brentonford/AutoHelm/AutoHelm roadmap 202512.md

# AutoHelm Recommendations

## Recommended Future Improvements

### Navigation & Waypoints

#### **4. Waypoint Preview Mode**
- **Problem:** No way to see route without committing to navigation
- **Solution:** Add "Preview Route" option showing distance, bearing, estimated time
- **Benefit:** Allows planning before engaging navigation

#### **5. Quick Waypoint Access**
- **Problem:** Need to open multiple screens to access waypoints
- **Solution:** Add floating button on map for quick waypoint list access
- **Benefit:** Faster waypoint selection while navigating

#### **6. Waypoint Categories/Tags**
- **Problem:** All waypoints in flat list, hard to organize
- **Solution:** Add tags/categories (Fishing Spots, Anchorage, Fuel, etc.)
- **Benefit:** Better organization for users with many waypoints

#### **7. Import/Export Waypoints**
- **Problem:** No way to backup or share waypoints
- **Solution:** Export to GPX/KML format, import from files
- **Benefit:** Data portability, sharing with others

#### **8. Waypoint Notes**
- **Problem:** Can't add details about location
- **Solution:** Add notes field to waypoints
- **Benefit:** Remember why location was marked

#### **9. Waypoint Photos**
- **Problem:** Visual context missing
- **Solution:** Allow attaching photo to waypoint
- **Benefit:** Better location identification

---

### Map & Visualization

#### **10. Distance Rings**
- **Problem:** Hard to judge distances visually
- **Solution:** Show distance rings around current location (100m, 500m, 1km)
- **Benefit:** Better spatial awareness

#### **11. Track/Breadcrumb Trail**
- **Problem:** No record of path traveled
- **Solution:** Draw path history on map (last 30min/1hr/session)
- **Benefit:** See where you've been, avoid revisiting areas

#### **12. Offline Map Tiles**
- **Problem:** Maps require internet connection
- **Solution:** Implement offline map tile caching
- **Benefit:** Function in remote areas without cellular

#### **13. Map Layer Options**
- **Problem:** Only standard map view available
- **Solution:** Add satellite, hybrid, nautical chart layers
- **Benefit:** Better navigation context for boating

#### **14. Weather Overlay**
- **Problem:** No weather information on map
- **Solution:** Optional weather radar/wind overlay
- **Benefit:** Better planning for conditions

---

### Status & Feedback

#### **15. Navigation Progress Bar**
- **Problem:** Only distance shown, unclear how far along route
- **Solution:** Show progress percentage or visual progress bar
- **Benefit:** Clearer sense of journey completion

#### **16. Arrival Notification**
- **Problem:** Easy to miss arrival at waypoint
- **Solution:** Add haptic feedback + prominent notification on arrival
- **Benefit:** Ensures user knows they've arrived

#### **17. Battery Status Warning**
- **Problem:** Helm device could die unexpectedly
- **Solution:** Show ESP32 battery level if available, warn at 20%
- **Benefit:** Prevents unexpected power loss

#### **18. GPS Quality Indicator**
- **Problem:** HDOP number meaningless to most users
- **Solution:** Show "Excellent/Good/Fair/Poor" GPS quality labels
- **Benefit:** More intuitive quality indication

#### **19. Connection Strength**
- **Problem:** Only shows connected/disconnected
- **Solution:** Show BLE signal strength (bars or percentage)
- **Benefit:** Know when moving out of range

---

### Motor Control

#### **20. Speed Presets**
- **Problem:** Repeatedly setting same speeds
- **Solution:** Save favorite speeds (Idle, Cruise, Fast)
- **Benefit:** One-tap speed changes

#### **21. Momentary Button Customization**
- **Problem:** Momentary button not always needed
- **Solution:** Allow remapping of "M" button to custom function
- **Benefit:** More flexible control

#### **22. Control Lock**
- **Problem:** Accidental button presses
- **Solution:** Add "Lock Controls" toggle requiring unlock to use buttons
- **Benefit:** Prevents unintended motor commands

#### **23. Visual Motor State**
- **Problem:** Hard to know if motor responding to commands
- **Solution:** Show last command sent and time elapsed
- **Benefit:** Better feedback on motor control

---

### Spot Lock

#### **24. Spot Lock History**
- **Problem:** Can't return to previous spot lock locations
- **Solution:** Save spot lock positions as special waypoints
- **Benefit:** Return to good fishing spots

#### **25. Spot Lock Drift Alert**
- **Problem:** Don't know if drifting too far
- **Solution:** Alert when drift exceeds threshold (configurable)
- **Benefit:** Know when repositioning needed

#### **26. Spot Lock Auto-Resume**
- **Problem:** If motor disabled, spot lock lost
- **Solution:** Option to auto-resume spot lock when conditions improve
- **Benefit:** Less manual re-engagement

---

### Settings & Preferences

#### **27. Unit Preferences**
- **Problem:** Only metric/imperial toggle
- **Solution:** Individual unit selection (distance, speed, depth)
- **Benefit:** More flexible customization

#### **28. Sound/Haptic Settings**
- **Problem:** No control over notifications
- **Solution:** Control sounds/haptics for different events
- **Benefit:** Customize feedback to preference

#### **29. Auto-Connect**
- **Problem:** Must manually connect each time
- **Solution:** Remember last device, auto-connect on app launch
- **Benefit:** Faster startup

#### **30. Night Mode**
- **Problem:** Bright screen at night
- **Solution:** Red/night mode for dark adaptation
- **Benefit:** Better night vision preservation

#### **31. Calibration Wizard**
- **Problem:** Compass calibration unclear
- **Solution:** Step-by-step visual calibration guide
- **Benefit:** Better initial setup

---

### Data & History

#### **32. Session History**
- **Problem:** No record of past trips
- **Solution:** Save session data (date, distance, time, waypoints visited)
- **Benefit:** Trip tracking and review

#### **33. Statistics**
- **Problem:** No usage data
- **Solution:** Show total distance traveled, time navigating, waypoints visited
- **Benefit:** Interesting metrics for users

#### **34. Export Trip Data**
- **Problem:** Can't share or analyze trips
- **Solution:** Export session to GPX/CSV
- **Benefit:** Use with other analysis tools

---

### Path Following (Future Feature)

#### **35. Multi-Waypoint Routes**
- **Problem:** Only single waypoint navigation
- **Solution:** Create and save multi-waypoint paths
- **Benefit:** Complex route navigation

#### **36. Route Optimization**
- **Problem:** Must manually order waypoints
- **Solution:** Auto-optimize waypoint order for shortest path
- **Benefit:** More efficient routing

#### **37. Route Sharing**
- **Problem:** Can't share favorite routes
- **Solution:** Share routes with other AutoHelm users
- **Benefit:** Community route discovery

---

### Safety Features

#### **38. Geofencing**
- **Problem:** Could navigate into restricted areas
- **Solution:** Define no-go zones on map
- **Benefit:** Automatic safety boundaries

#### **39. Low Water Alert**
- **Problem:** Risk of running aground
- **Solution:** Alert when approaching shallow areas (if depth data available)
- **Benefit:** Grounding prevention

#### **40. Anchor Drag Alert**
- **Problem:** Don't know if anchor dragging
- **Solution:** Set anchor position, alert if exceeding radius
- **Benefit:** Anchor watch feature

#### **41. Connection Loss Protocol**
- **Problem:** Unclear what happens if BLE drops
- **Solution:** Configurable behavior (stop, continue nav, return to start)
- **Benefit:** Safer autonomous operation

---

### User Onboarding

#### **42. First-Time Tutorial**
- **Problem:** Features not immediately obvious
- **Solution:** Interactive tutorial on first launch
- **Benefit:** Faster learning curve

#### **43. Context Tooltips**
- **Problem:** Technical terms unclear
- **Solution:** Info buttons explaining HDOP, bearing, etc.
- **Benefit:** Better understanding

#### **44. Demo Mode**
- **Problem:** Hard to test without hardware
- **Solution:** Simulated GPS/compass for testing UI
- **Benefit:** Try before buying hardware

---

### Performance & Polish

#### **45. Background GPS Updates**
- **Problem:** App must be foreground to navigate
- **Solution:** Continue navigation in background
- **Benefit:** Multitask while navigating

#### **46. Widget Support**
- **Problem:** Must open app for status
- **Solution:** iOS widget showing GPS/nav status
- **Benefit:** Quick glance information

#### **47. Apple Watch App**
- **Problem:** Phone must be nearby
- **Solution:** Control basic functions from watch
- **Benefit:** More convenient control

#### **48. Haptic Feedback**
- **Problem:** Only visual feedback
- **Solution:** Haptic on button press, arrival, warnings
- **Benefit:** Better tactile feedback

#### **49. Landscape Mode**
- **Problem:** Only portrait orientation
- **Solution:** Support landscape for larger map view
- **Benefit:** Better visibility

---

## Priority Matrix

### Must-Have (Already Implemented)
- ✅ Navigation state clarity
- ✅ Motor response reset
- ✅ Speed control keyboard entry
- ✅ RF/Spot Lock disables navigation

### Should-Have (Near Term)
- Waypoint preview mode (#4)
- Distance rings (#10)
- GPS quality labels (#18)
- Unit preferences (#27)
- Auto-connect (#29)

### Nice-to-Have (Mid Term)
- Waypoint categories (#6)
- Import/export waypoints (#7)
- Track history (#11)
- Night mode (#30)
- Session history (#32)

### Future Enhancements (Long Term)
- Multi-waypoint paths (#35)
- Offline maps (#12)
- Weather overlay (#14)
- Geofencing (#38)
- Apple Watch app (#47)

---

## Implementation Notes

**Quick Wins (1-2 hours each):**
- GPS quality labels (#18)
- Distance rings (#10)
- Speed presets (#20)
- Visual motor state (#23)

**Medium Effort (1-2 days each):**
- Waypoint categories (#6)
- Track history (#11)
- Session history (#32)
- Night mode (#30)

**Major Features (1-2 weeks each):**
- Multi-waypoint paths (#35)
- Offline maps (#12)
- Import/export (#7)
- Background GPS (#45)

---

## User Feedback Collection

To prioritize these improvements, consider:
1. Usage analytics (which features used most)
2. User surveys (what do people want most)
3. Support requests (what causes confusion)
4. Community voting (let users prioritize)
