brentonford/AutoHelm/(commit log)

2025-12-13 feat: ESP32 Project Setup
2025-12-13 feat: CC1101 SPI Communication
2025-12-13 feat: Remote Button Transmission
2025-12-13 feat: Magnetometer Integration
2025-12-13 feat: Sensor Data Validation
2025-12-14 feat: Heading Correction Logic
    [DataModels.h, Helm.ino]
2025-12-14 fix: typo in BleManager.h
    [BleManager.h]
2025-12-19 feat: motor control interface
2025-12-19 fix: reduce motor control delay
    [Helm.ino]
2025-12-23 feat: device status updates improved
2025-12-24 feat: verifies motor response
2025-12-25 feat: remove distance rings and track points
2025-12-26 feat: improved spot lock motor and speed detection
2025-12-27 feat: compass calibration
2025-12-28 feat: add bearing to Spot Lock card
2025-12-30 feat: improve steering function
2025-12-31 feat: replace current map position with heading arrow
2026-01-23 fix: improve spotlock calibration
2026-01-24 fix: steering before thrust
    [DataModels.h]
2026-01-24 fix: Cable Tangle Prevention
2026-01-27 fix: inspect code and fix critical, major issues
    [BleManager.cpp, BleManager.h, CC1101.cpp, CC1101.h, CompassManager.cpp, CompassManager.h, GpsManager.cpp, Helm.ino]
2026-03-30 re archirtect spotlock algorith to helm device
2026-03-31 open-loop motor improvements
2026-04-06 update north calibration settings
2026-04-06 calibration zero offsets update fixed
2026-06-18 feat(helm): Phase 1 mode arbiter, non-blocking loop, BLE command queue
    Introduce HelmModeManager as the single RF authority with sequenced
    transitions between Spot Lock and waypoint navigation, including a safe
    nav-arrival handoff that waits for ramp-down before engaging Spot Lock.
    Replace blocking delay()/transmitHold() paths in the main loop with
    non-blocking motor zeroing, emergency stop, manual RF bursts, and
    rapid compass sampling. BLE GATT writes now enqueue commands for the
    main loop to drain, and advertising restart is deferred out of callbacks.
2026-06-18 feat(helm): Phase 2 GPS preconditions, fault state, protocol cleanup
    Validate GPS fix, freshness, satellites, HDOP, and target coordinates on
    the device before engaging Spot Lock or navigation. Re-validate deferred
    starts after mode transitions complete.
    Set HelmState::Fault and emit GPS_LOST when controllers abort due to
    sustained GPS quality failure. Clear fault on user cancel/disengage or
    successful re-engage.
    Remove premature NAV_START/SPOTLOCK_ENGAGE BLE acks; firmware sends a
    single ack or specific error after validation. Deprecate filterWindowSize
    in protocol parsing and remove it from iOS settings UI. Clarify that
    disconnectGracePeriodSeconds is iOS-only. iOS controllers react to f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
2026-06-21 feat(helm): Phase 3 DRY motor base, NVS calibration, test alignment
    Extract AutopilotMotorController with shared non-blocking motor control,
    GPS quality checks, Kalman distance filtering, and steering helpers.
    SpotLockController and WaypointNavController now inherit the base,
    reducing duplicated logic by ~220 lines.
    Persist compass calibration to ESP32 NVS on setCalibration() and
    stopCalibration(); load stored values in CompassManager::begin().
    Auto-upload NavSettings on BLE connect alongside Spot Lock settings
    and calibration. Replace obsolete sliding-window iOS tests with
    Kalman distance filter tests matching firmware NavMath.h.
2026-06-21 feat(helm): Phase 4 UX consistency and firmware performance polish
    Drive Spot Lock and navigation UI state from BLE telemetry and command
    responses instead of optimistic local flags. Add engaging/starting
    indicators with timeouts; disable manual RF and Spot Lock engage when
    navigation is active.
    Use a member char buffer for sensor status JSON to avoid heap String
    allocations every 500 ms. Throttle SPOTLOCK_JOG to 200 ms on firmware
    and acknowledge accepted jog commands. Replace flat-earth jog projection
    with great-circle calcDestination in NavMath.h.
    Helm Control cancels autonomous modes before manual RF when idle, and
    disables manual controls with clear messaging while autonomous modes ru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
2026-06-21 feat(helm): Phase 5 BLE auth and synced disconnect grace policy
    Gate privileged BLE commands (RF, Spot Lock, navigation, calibration)
    behind shared-secret AUTH validated against BLE_AUTH_SECRET in
    secrets.h. Unauthenticated centrals receive AUTH_REQUIRED; failed
    attempts lock out after five tries until reconnect.
    Sync disconnect grace period from iOS to firmware as SPOTLOCK_SETTINGS
    field 21. Firmware waits the configured grace before manual-mode safety
    stop on BLE drop; reconnect within grace cancels the pending stop.
    iOS sends AUTH on connect, queues commands until AUTH_OK, shows
    reconnecting state during grace, and adds a pairing secret field in
    Settings. Motor and navigation controls r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
2026-10-30 feat: capture the Watersnake handset id from Waypoint
    The helm listens on the CC1101, confirms two different buttons from the same handset, and stores that id so each motor can be paired without a hardcoded DEVICE_ID.
2026-10-30 docs: rewrite the README around the current helm and the control spec
    The README now matches the firmware and Waypoint app, and points at the design spec for the spot-lock and navigate behavior still to land before a water test.
2026-10-30 fix: hold and navigate from raw GPS with presses the motor accepts
    Filtered heading and short bursts never moved the boat reliably. Decisions now use raw distance and heading, presses last at least 500 ms, and navigation holds one level until arrival.
